harvie256/phasor_fpga/sigrok/README.md

## A bare minimum Sigrok Protocol Decoder

This decoder is for the data stream lines of the AD7779 ADC.  For simplicy of the code, only the first data line is decoded.
Simple to add the others, however it's been kept very simple to allow easy understanding of how a PD can be created.

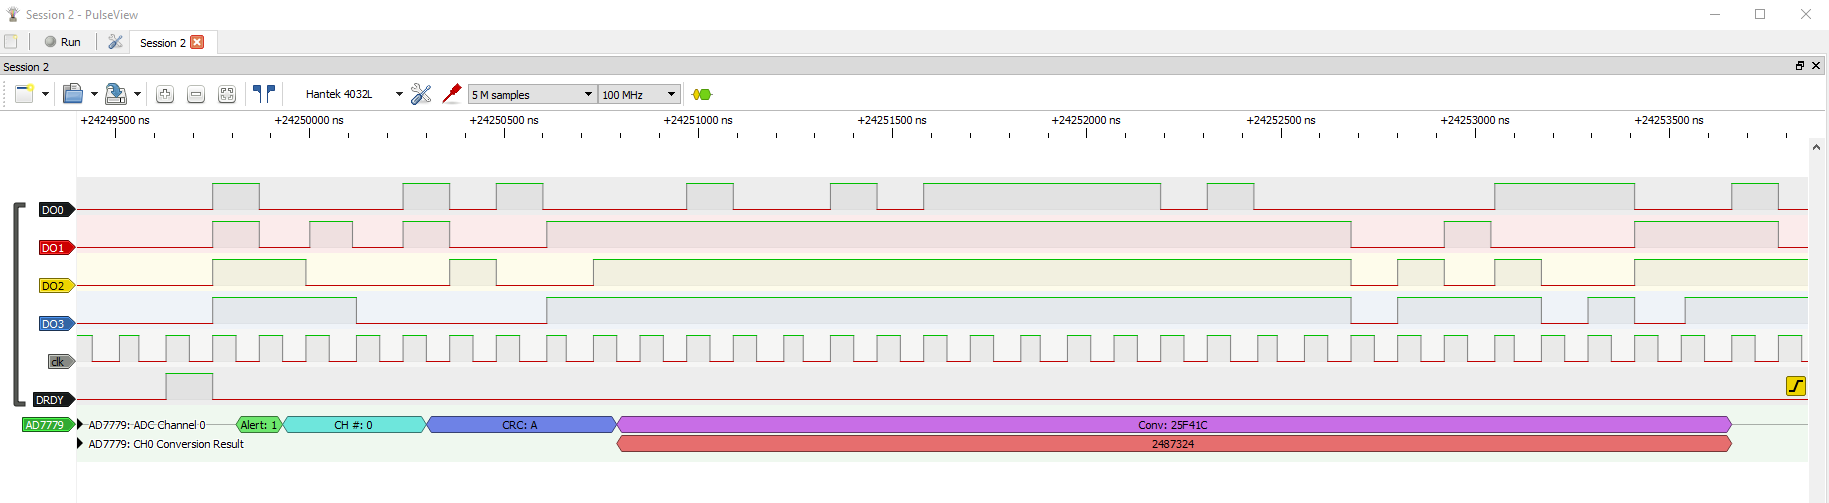
[picture p2: sigrok/Annotation 2020-06-17 120243.png]
Pulseview annotation
