harvie256/phasor_fpga/sigrok/adc_output.png

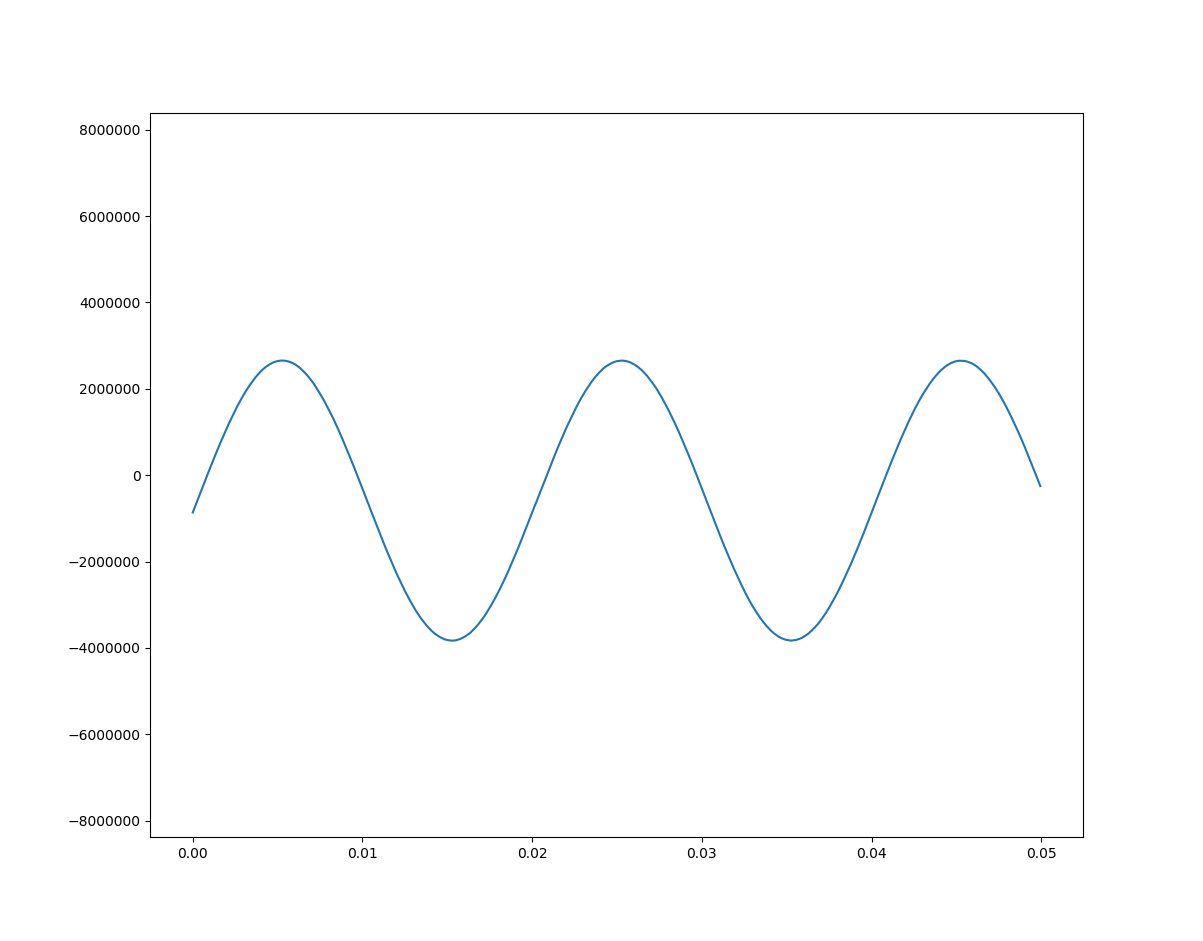
sigrok/adc_output.png
