harvie256/phasor_fpga/FPGA_PMU_PCB/fpga_pmu_pcb_board.pdf

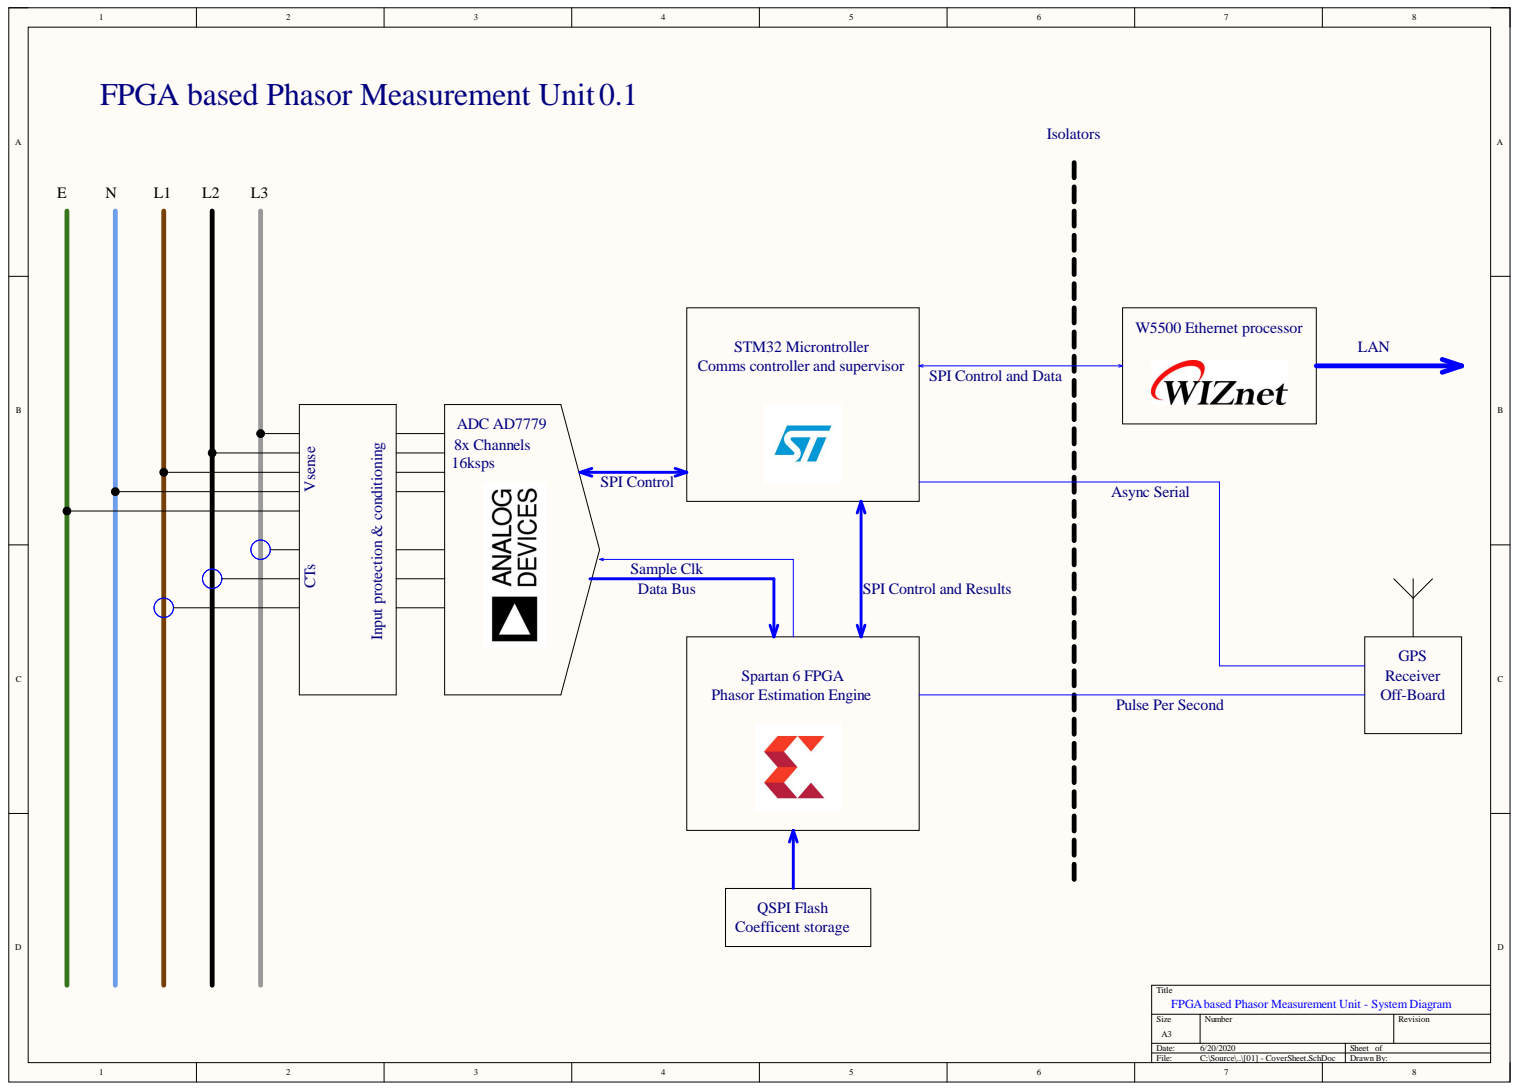
[picture p4: page 1]

FPGA based Phasor Measurement Unit 0.1

STM32 Microntroller
Comms controller and supervisor

SPI Control and Data

SPI Control and Results

Title
FPGA based Phasor Measurement Unit - System Diagram

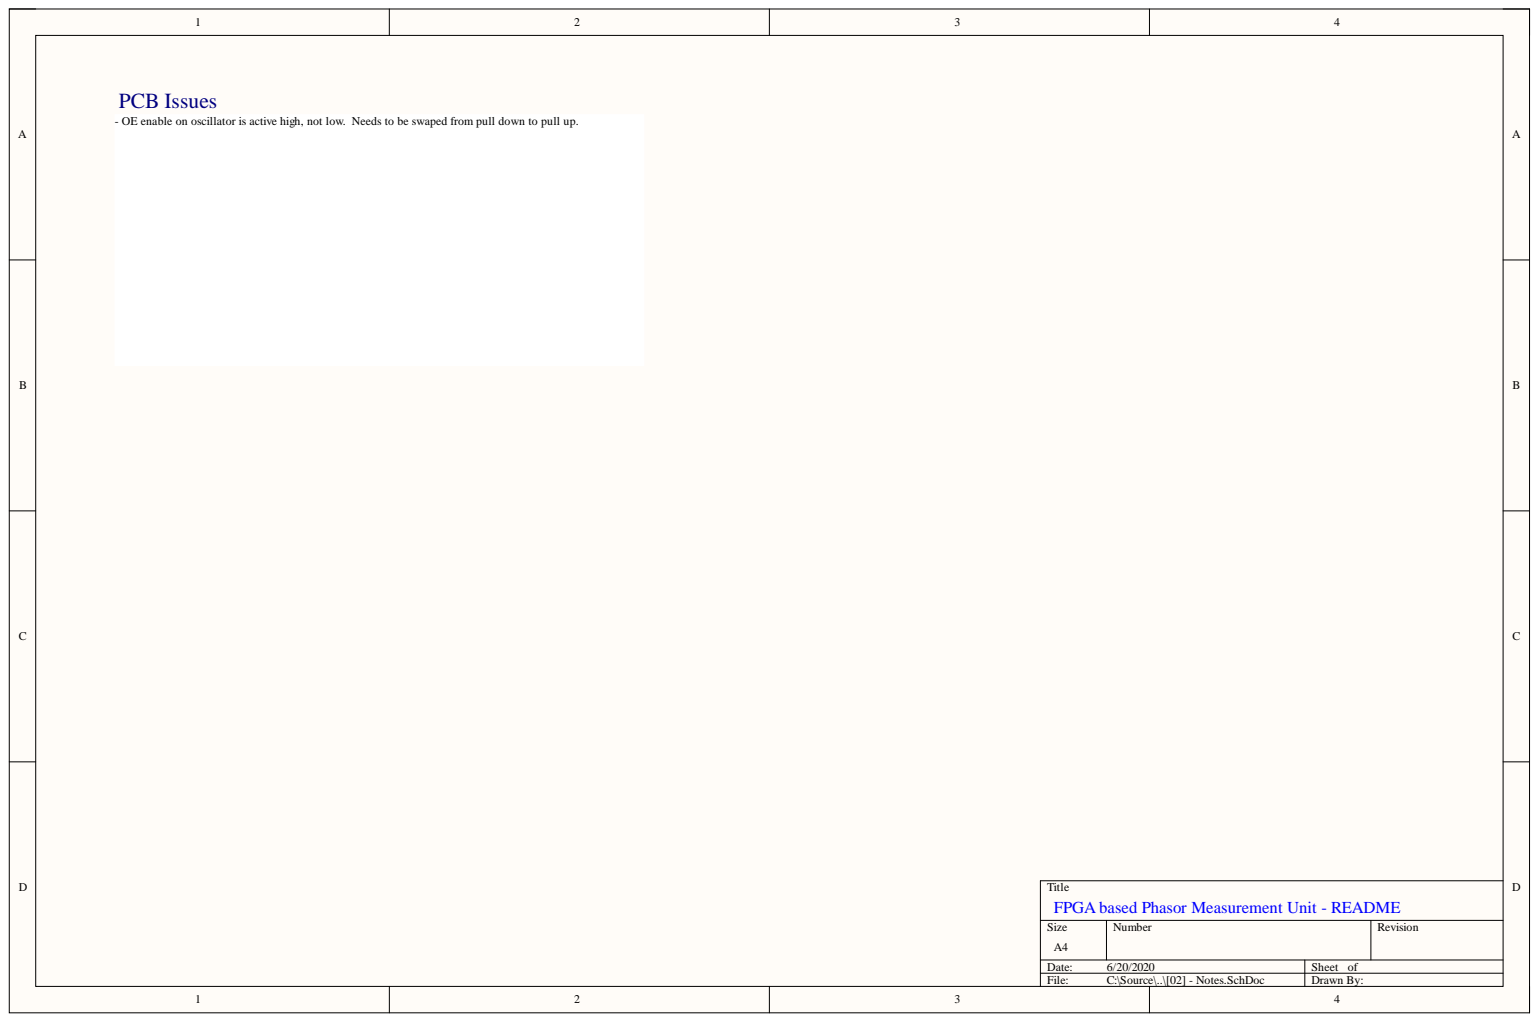
[picture p5: page 2]

- OE enable on oscillator is active high, not low. Needs to be swaped from pull down to pull up.

Title
FPGA based Phasor Measurement Unit - README

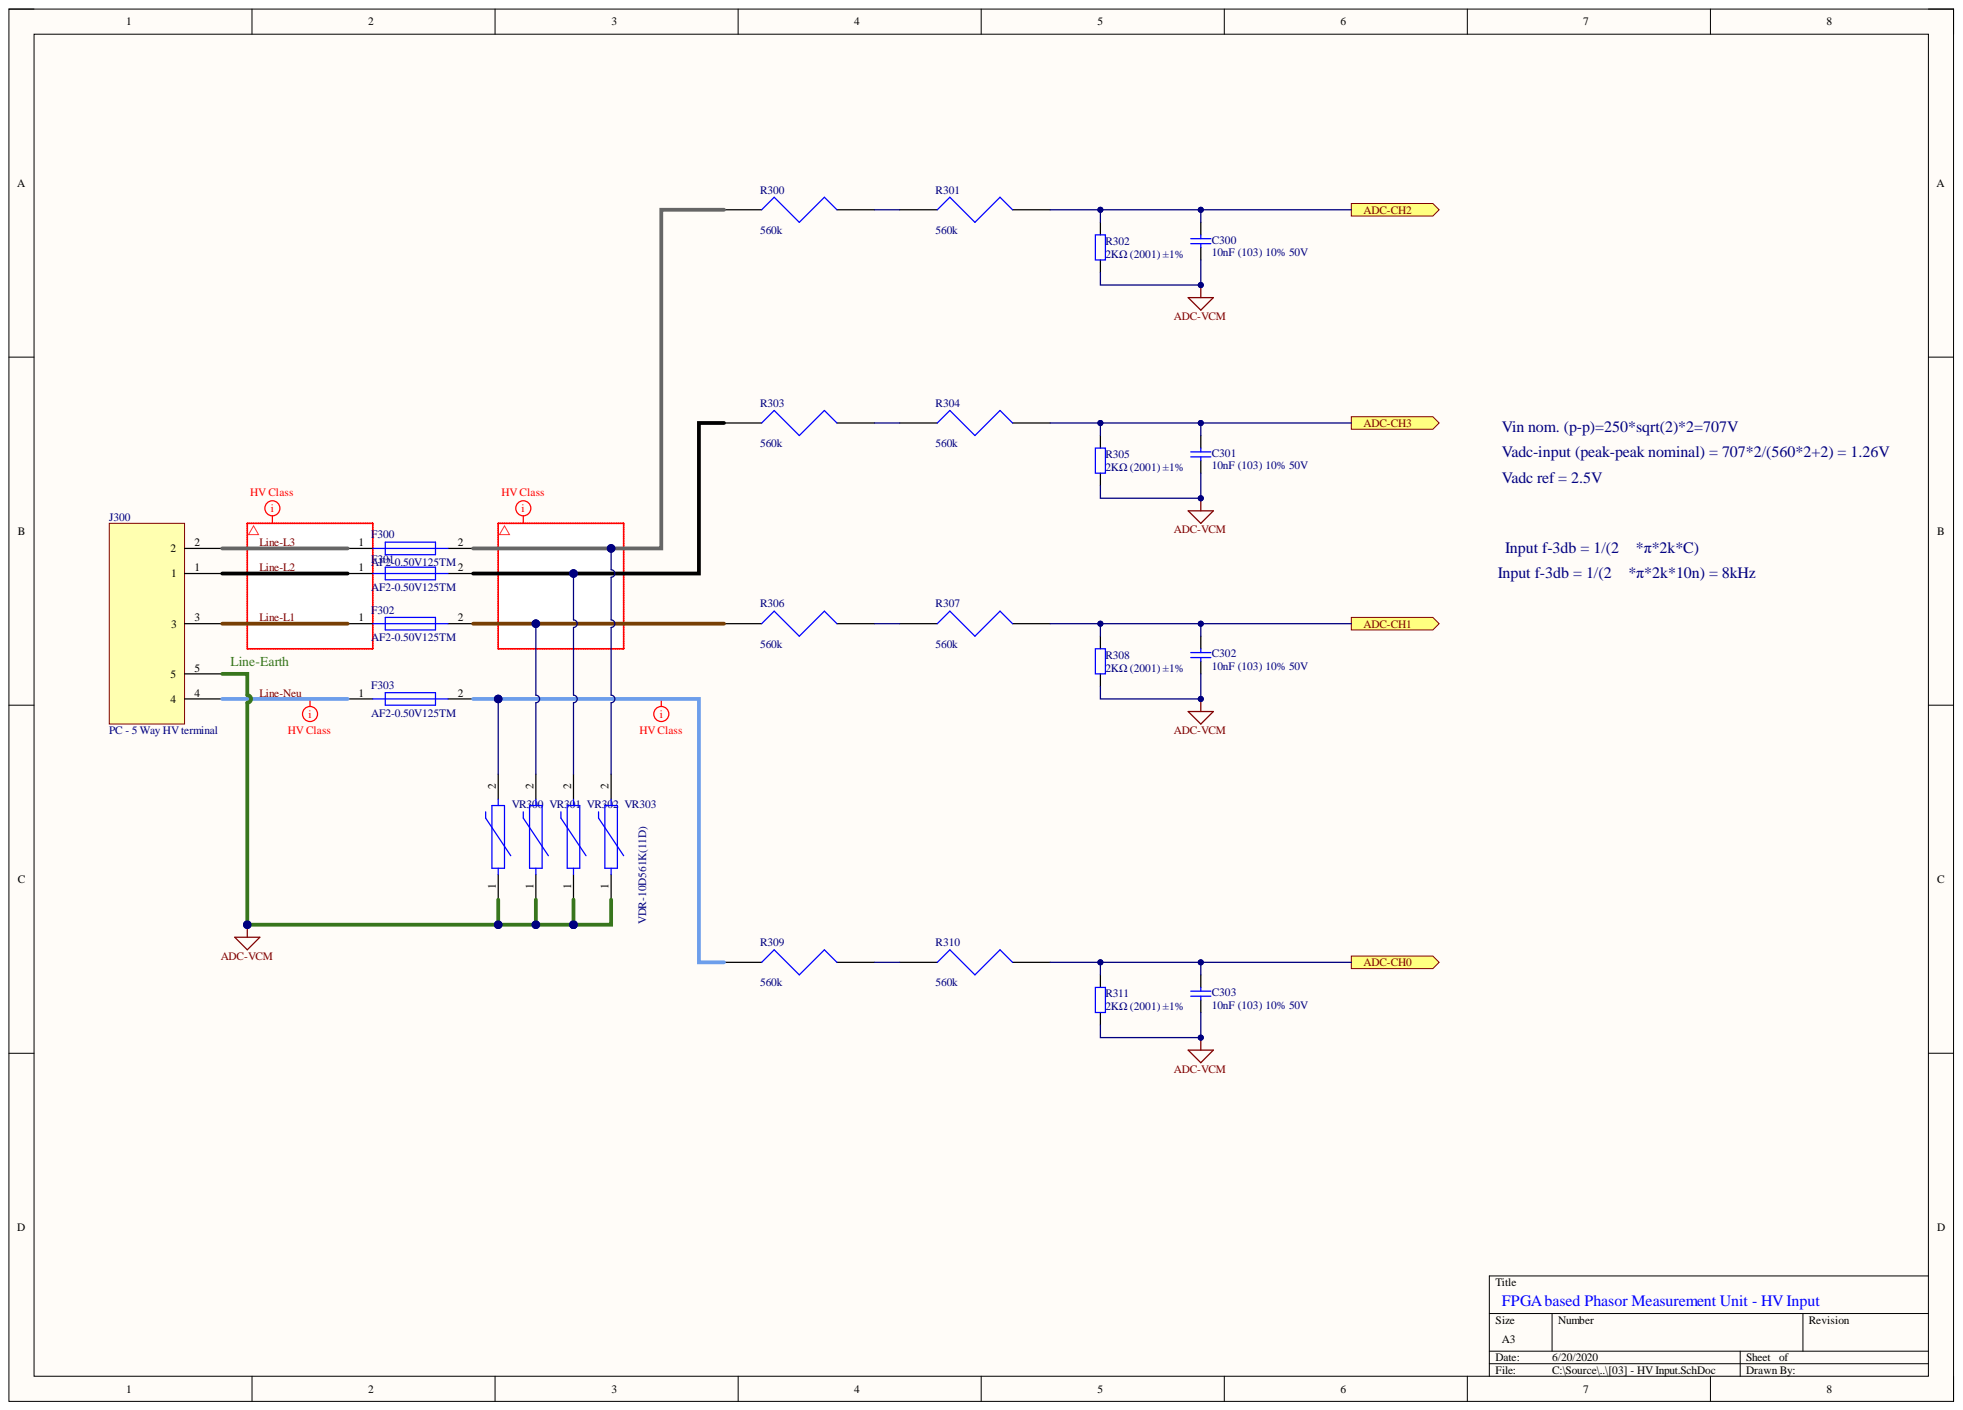
[picture p6: page 3]

Vin nom. (p-p)=250*sqrt(2)*2=707V
Vadc-input (peak-peak nominal) = 707*2/(560*2+2) = 1.26V
Vadc ref = 2.5V

PC - 5 Way HV terminal

Title
FPGA based Phasor Measurement Unit - HV Input

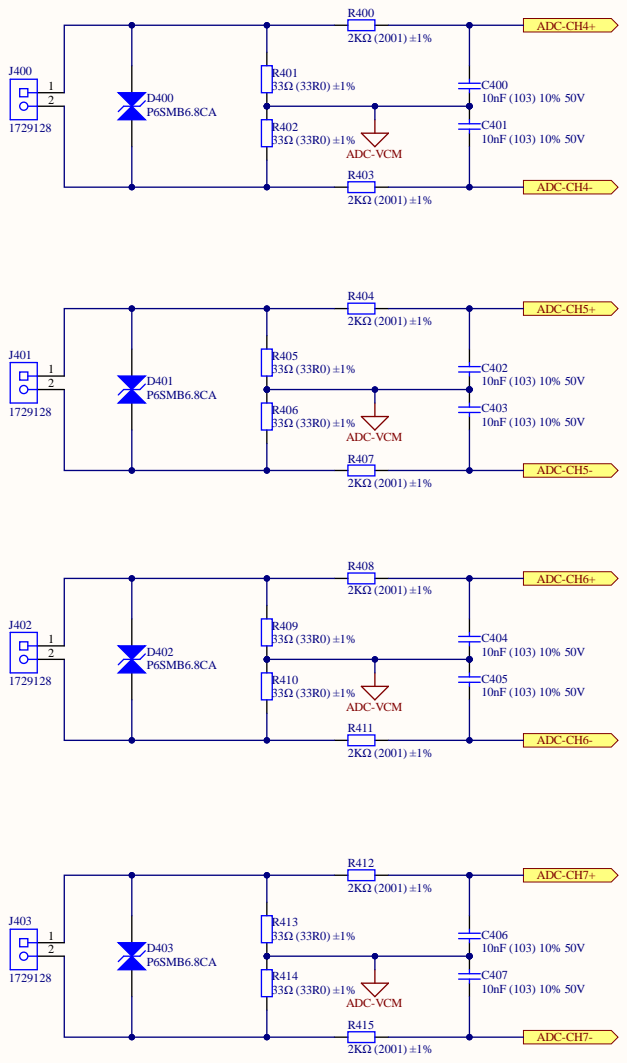
[picture p7: page 4]

Title
FPGA based Phasor Measurement Unit - CT Input

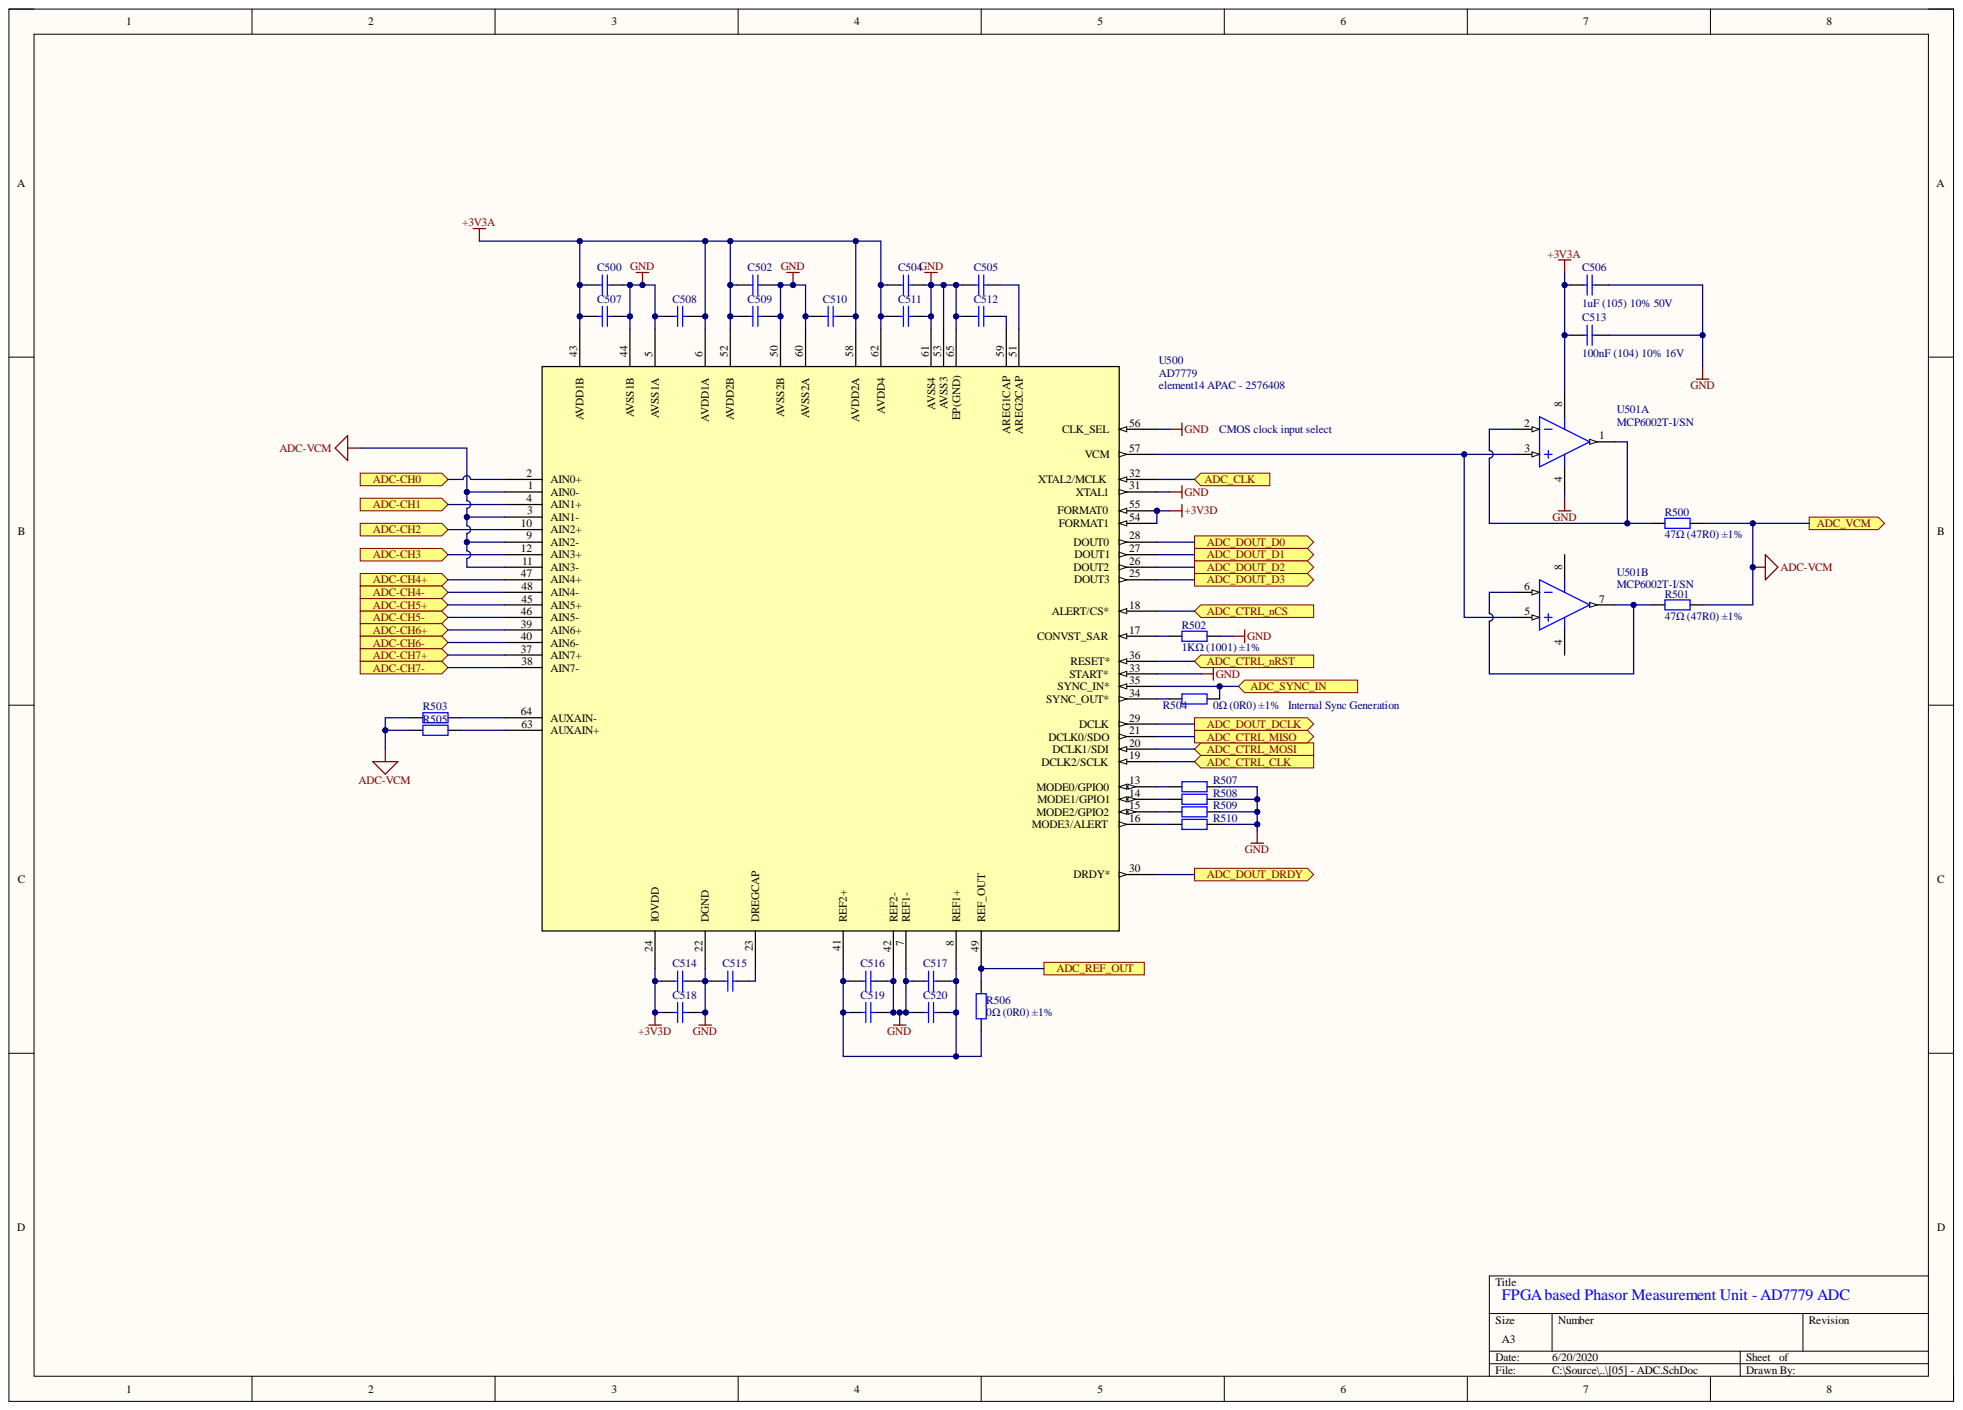
[picture p8: page 5]

GND CMOS clock input select

R505 | AUXAIN+ 63 AUXAIN- 64

R508
R509
R510

Title
FPGA based Phasor Measurement Unit - AD7779 ADC

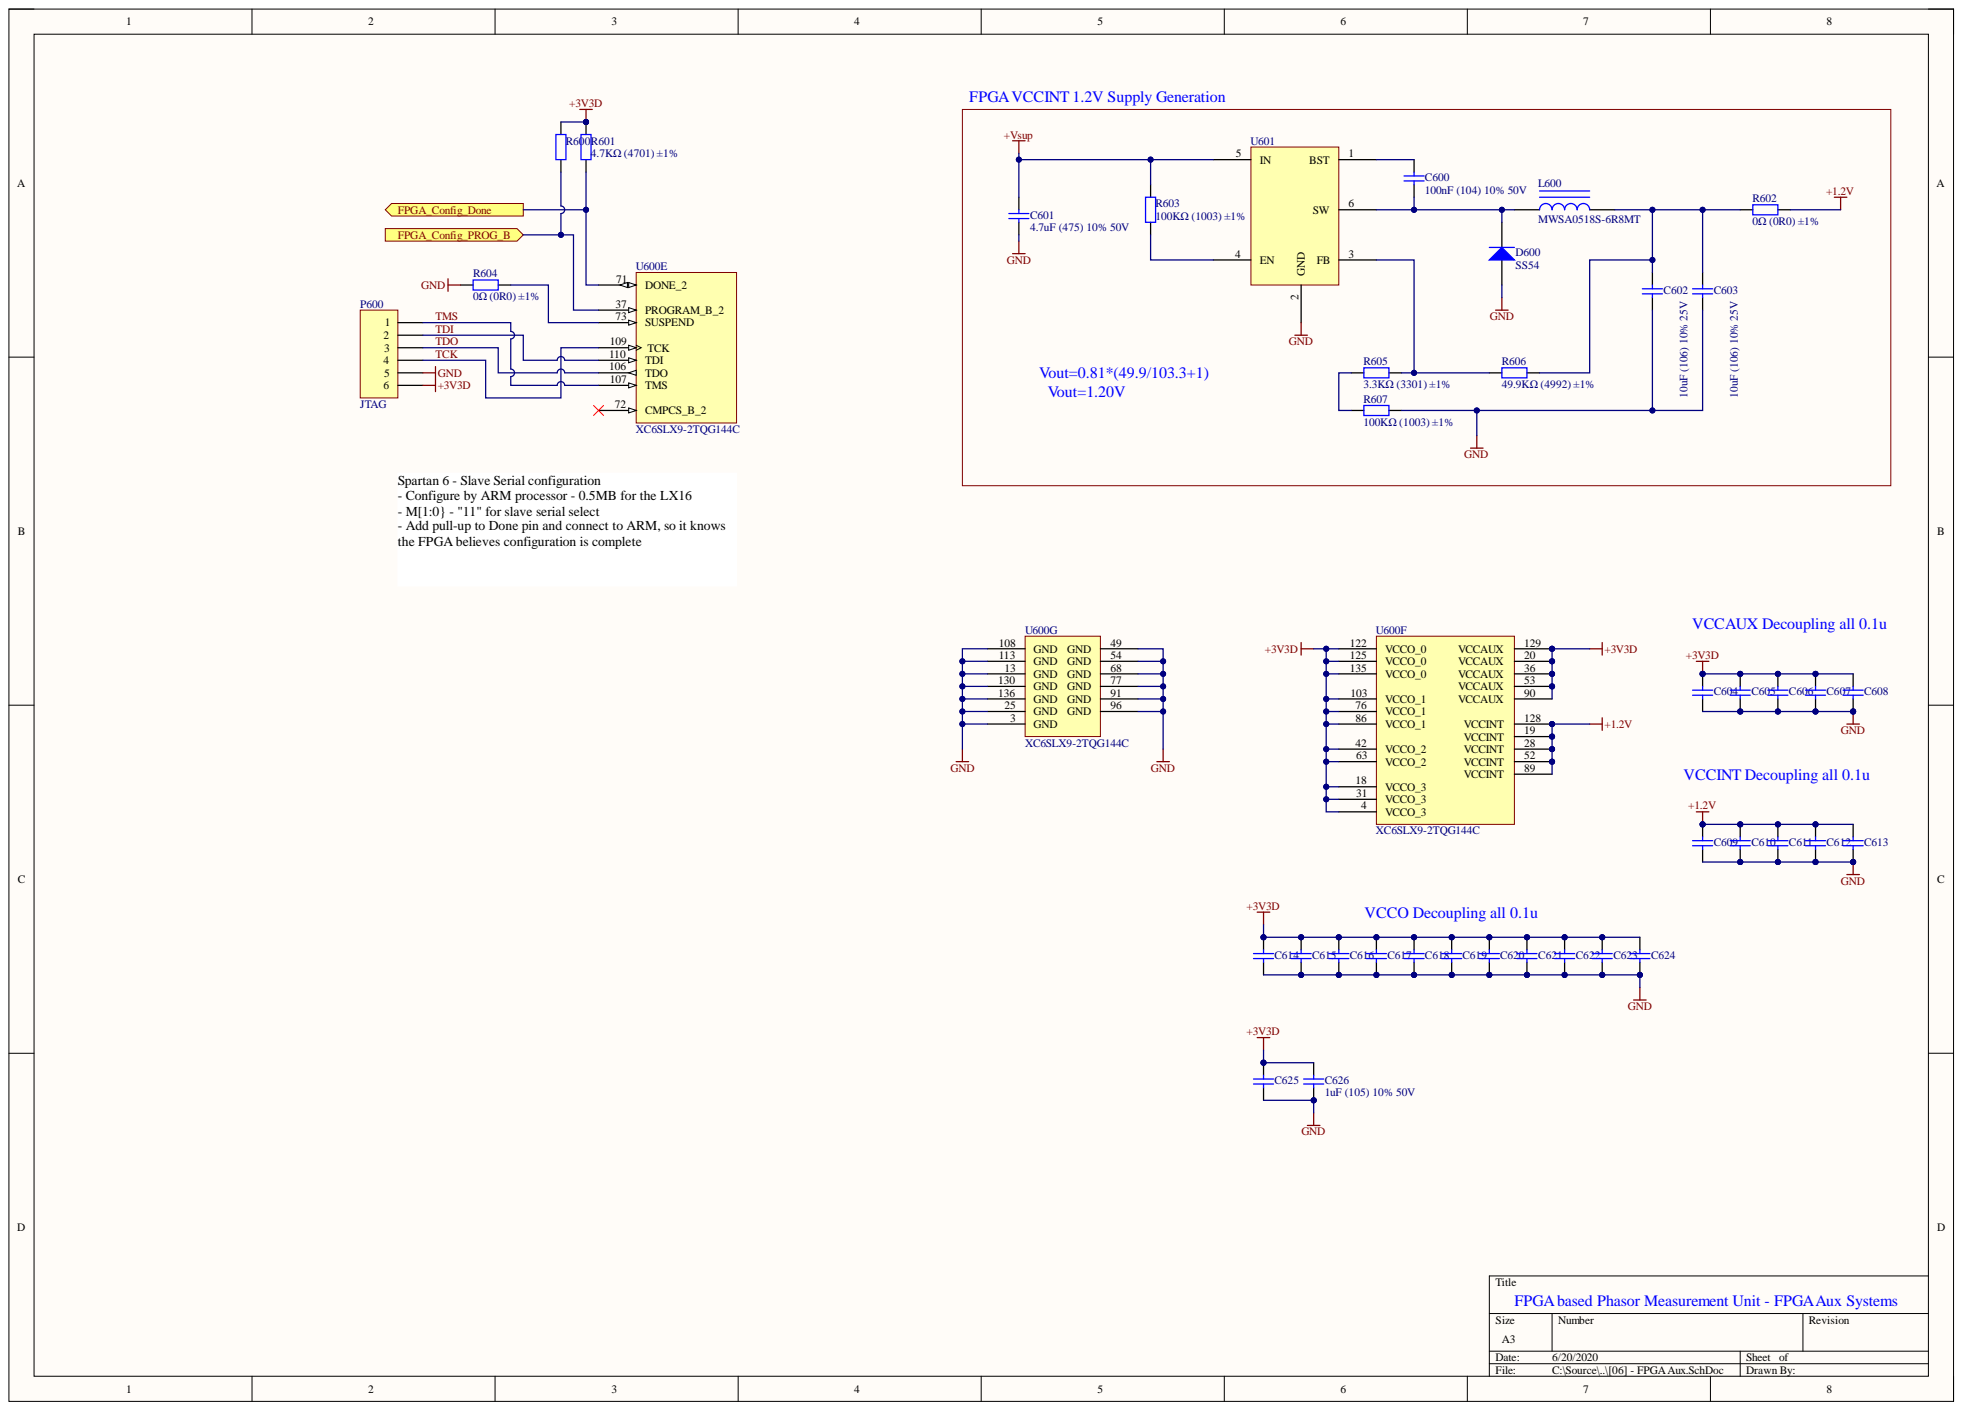
[picture p9: page 6]

TDO
TCK | TDI 110

Spartan 6 - Slave Serial configuration
- Configure by ARM processor - 0.5MB for the LX16
- M[1:0} - "11" for slave serial select
- Add pull-up to Done pin and connect to ARM, so it knows
the FPGA believes configuration is complete

VCCO_3 18

VCCO_3 4

Title
FPGA based Phasor Measurement Unit - FPGAAux Systems

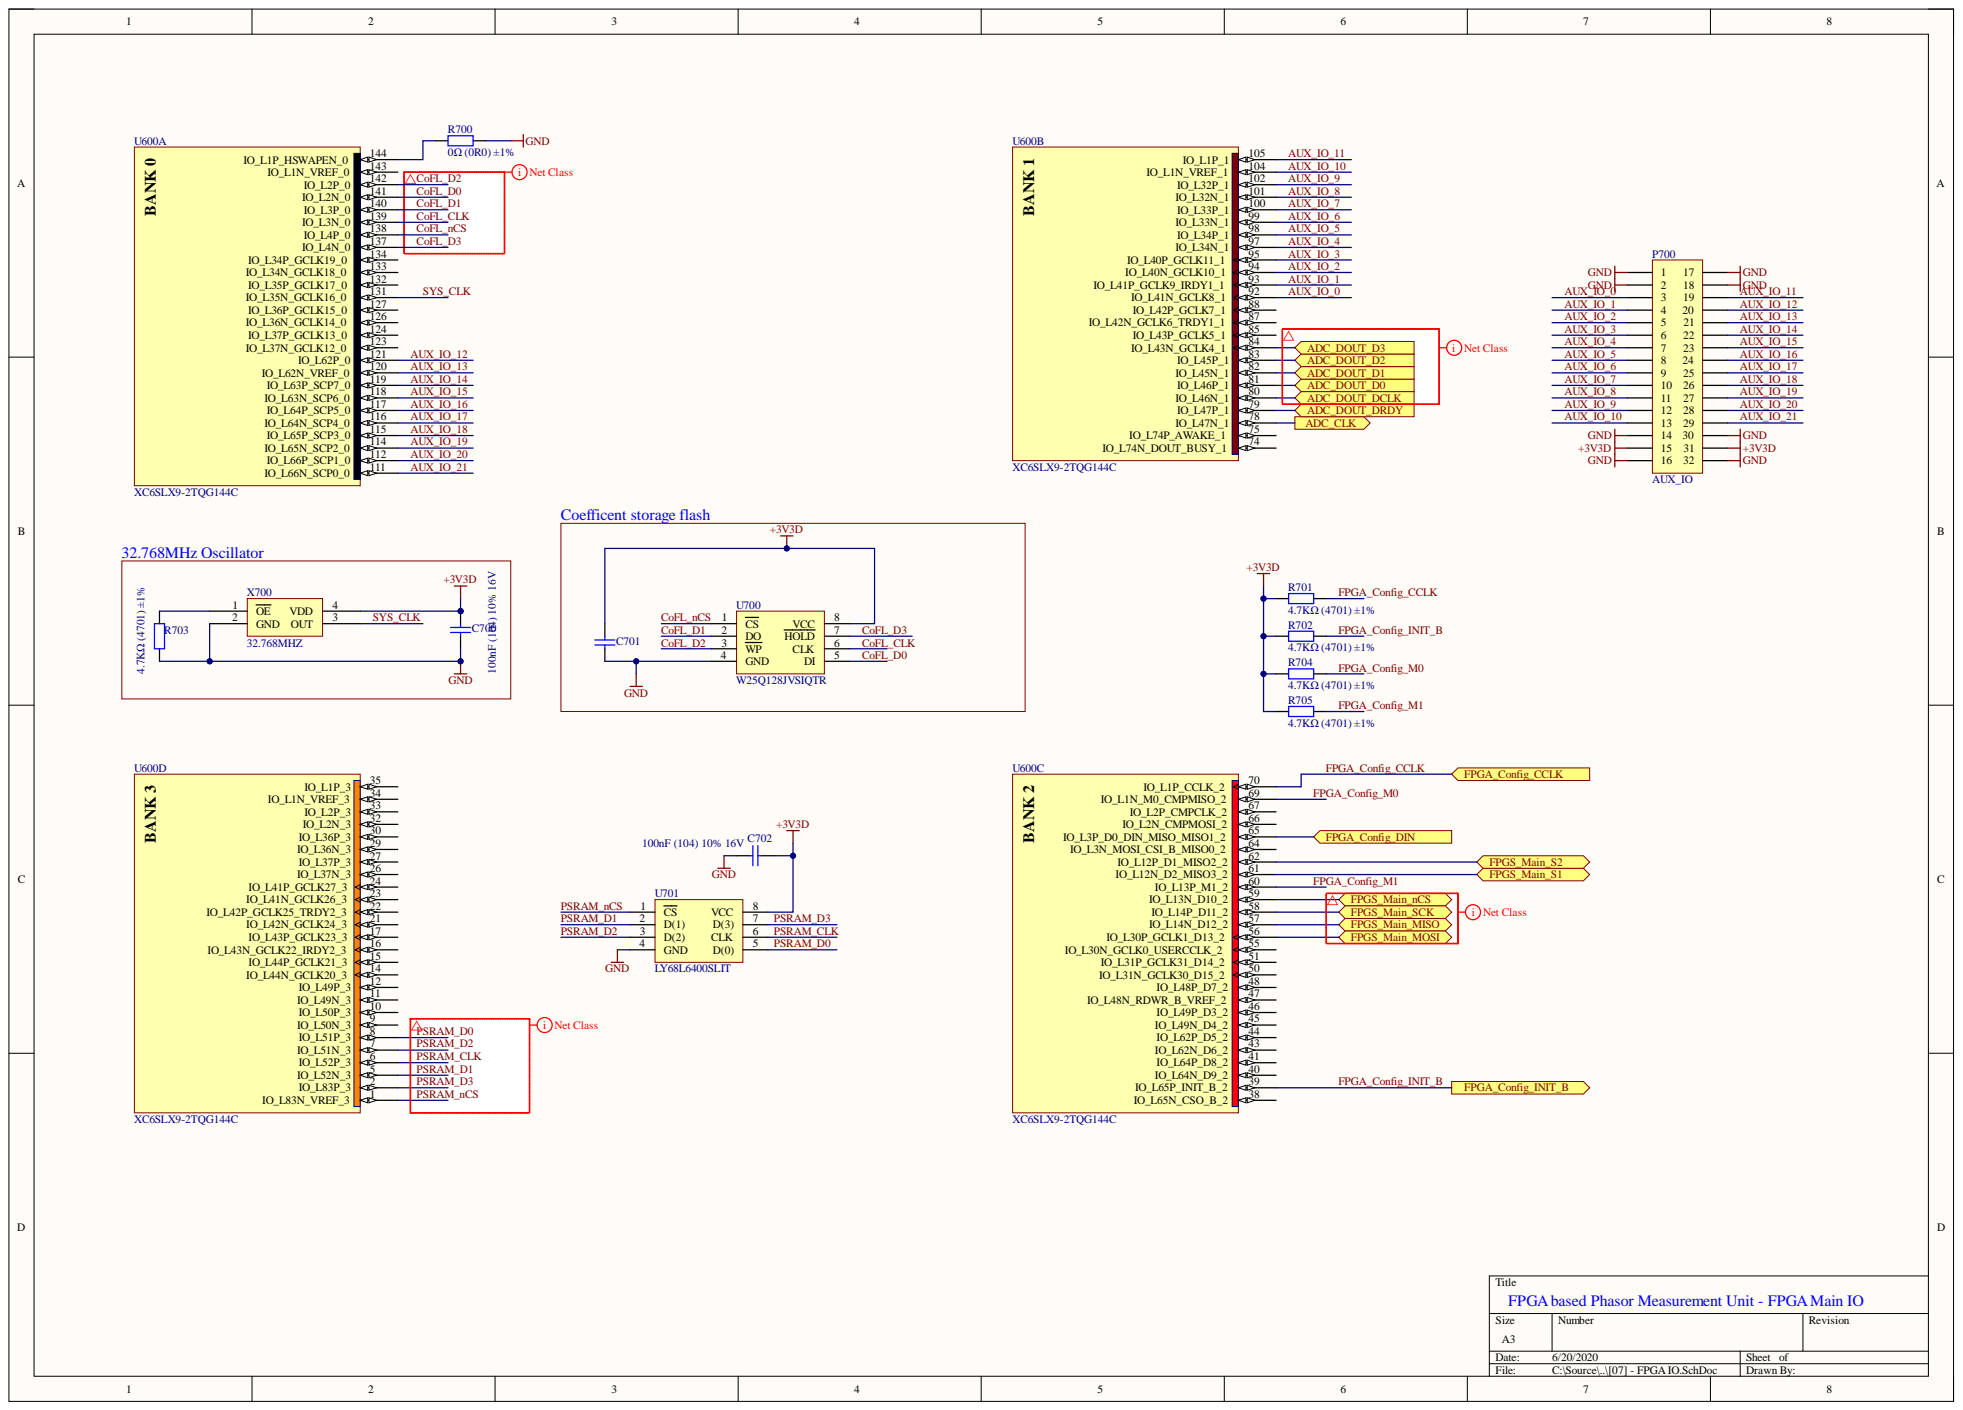
[picture p10: page 7]

Title
FPGA based Phasor Measurement Unit - FPGA Main IO

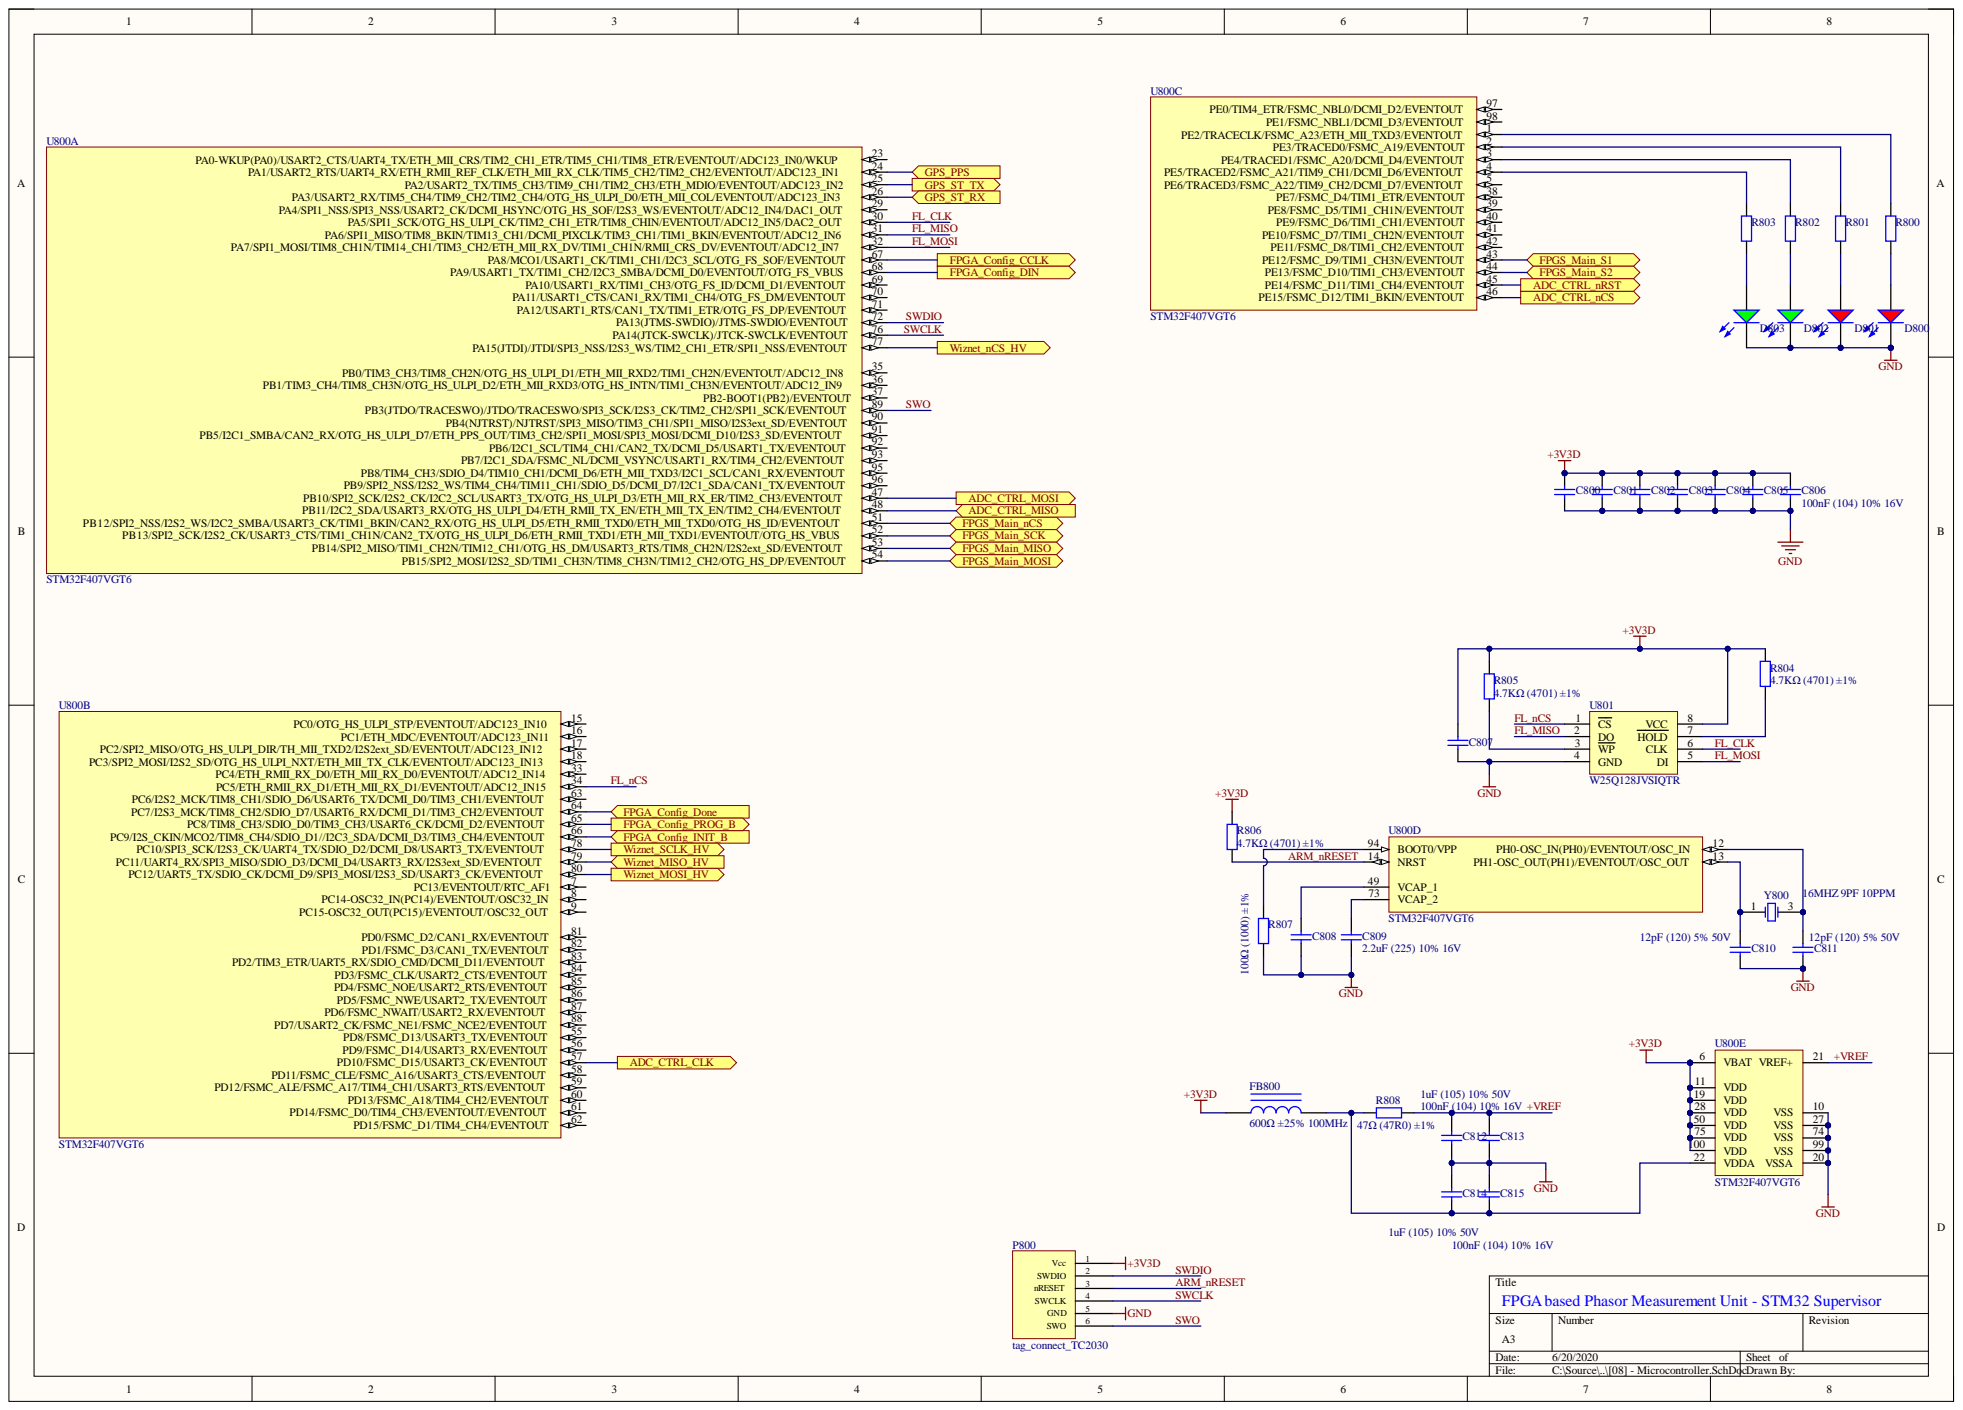
[picture p11: page 8]

Title
FPGA based Phasor Measurement Unit - STM32 Supervisor

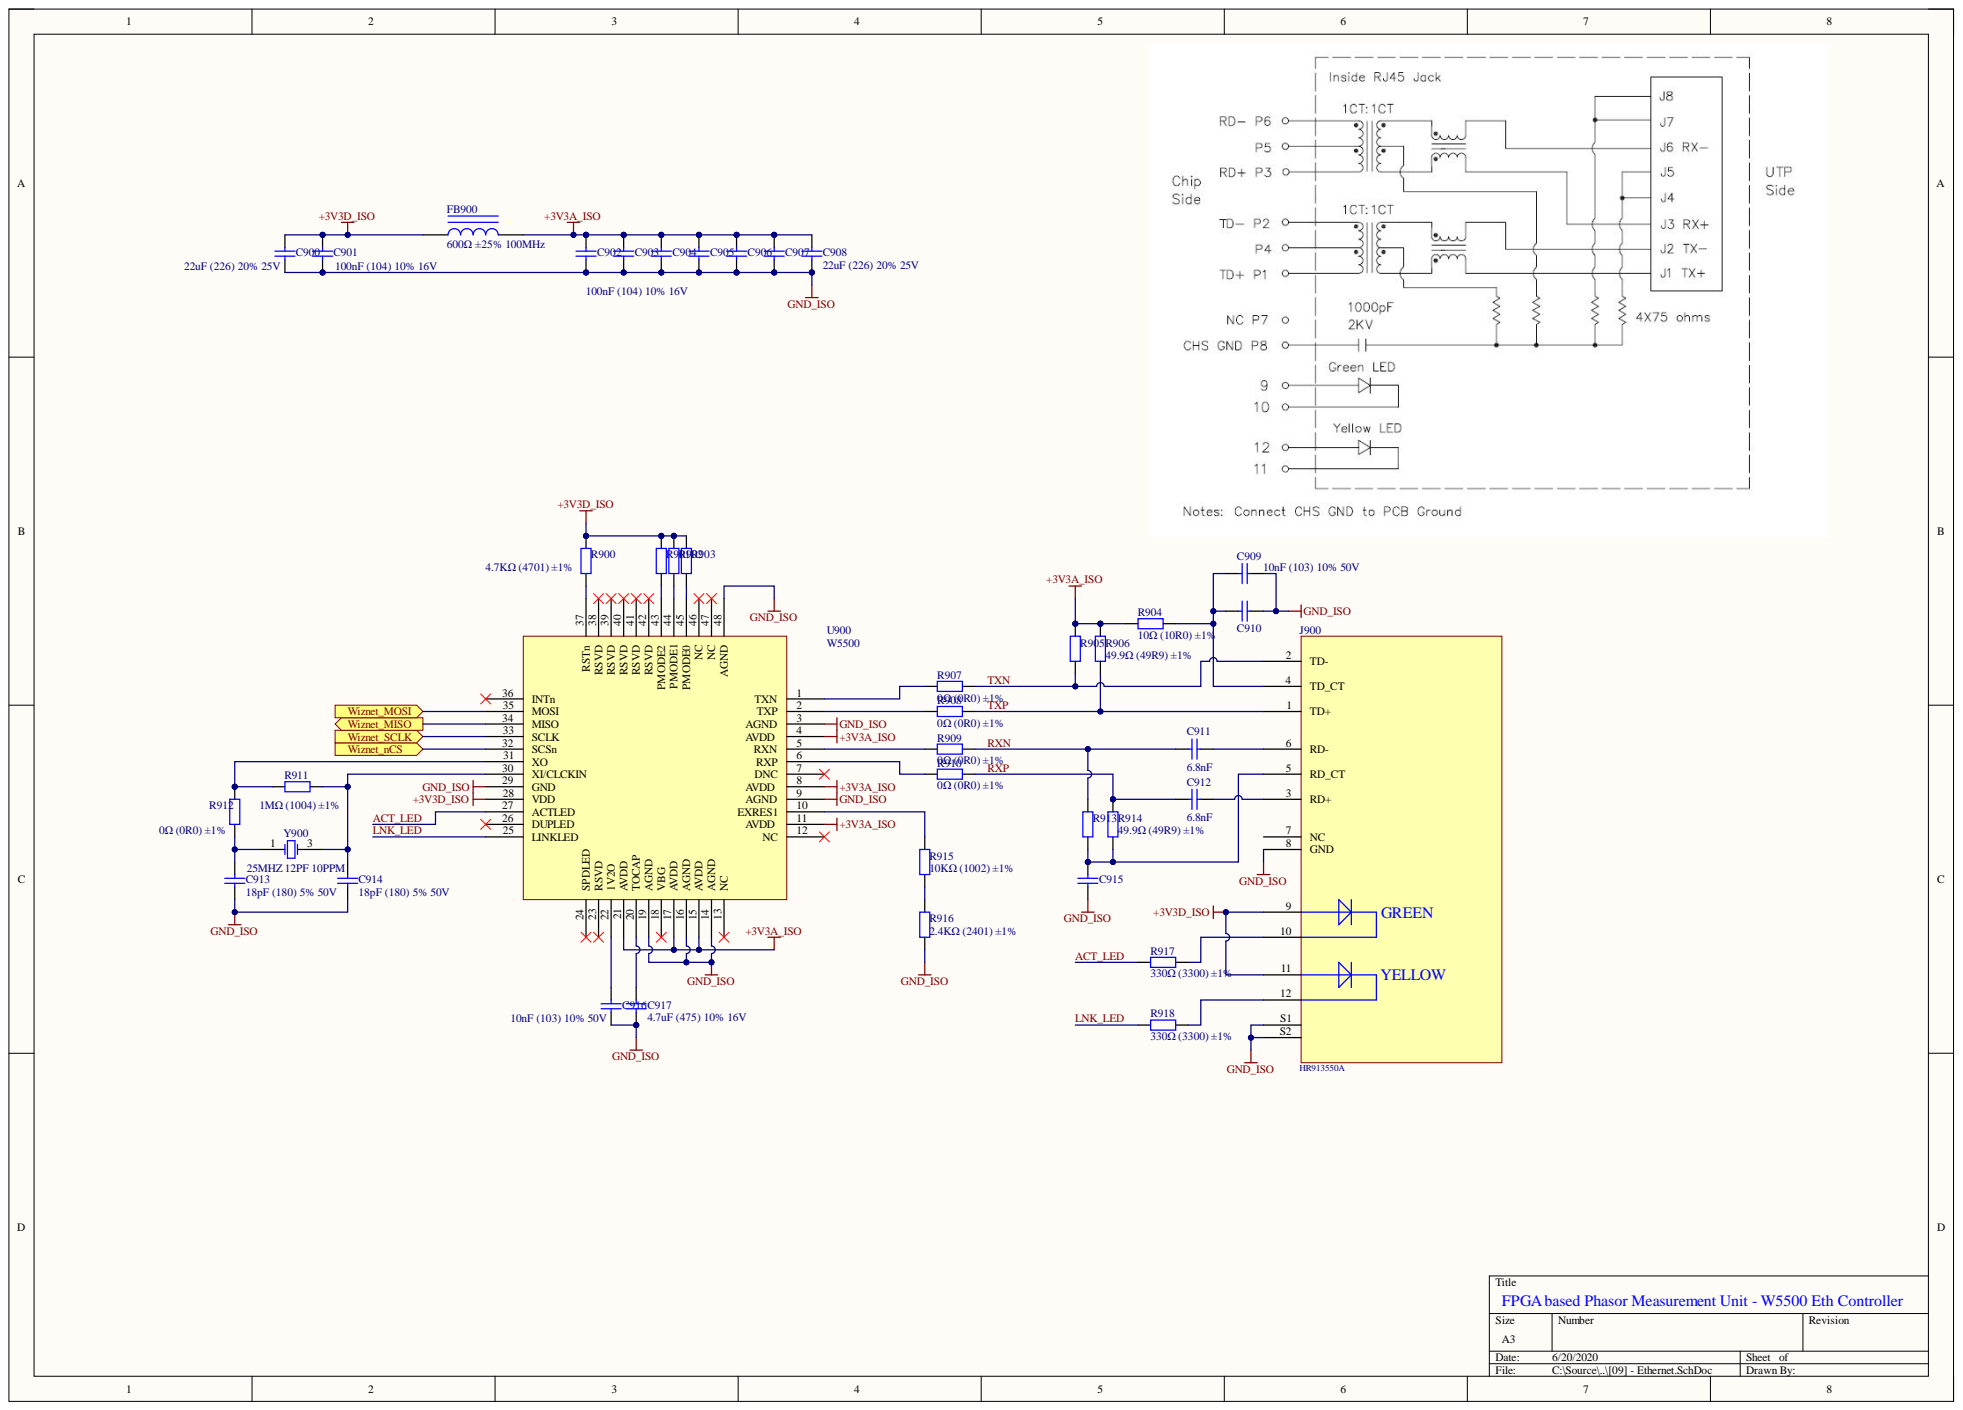
[picture p12: page 9]

TXN

TXP | TD+ 1

NC 13 AGND 14 AVDD 15 AGND 16 AVDD 17 VBG 18 AGND 19 TOCAP 20 AVDD 21 1V2O 22 RSVD 23 SPDLED 24

S1
S2

Title
FPGA based Phasor Measurement Unit - W5500 Eth Controller

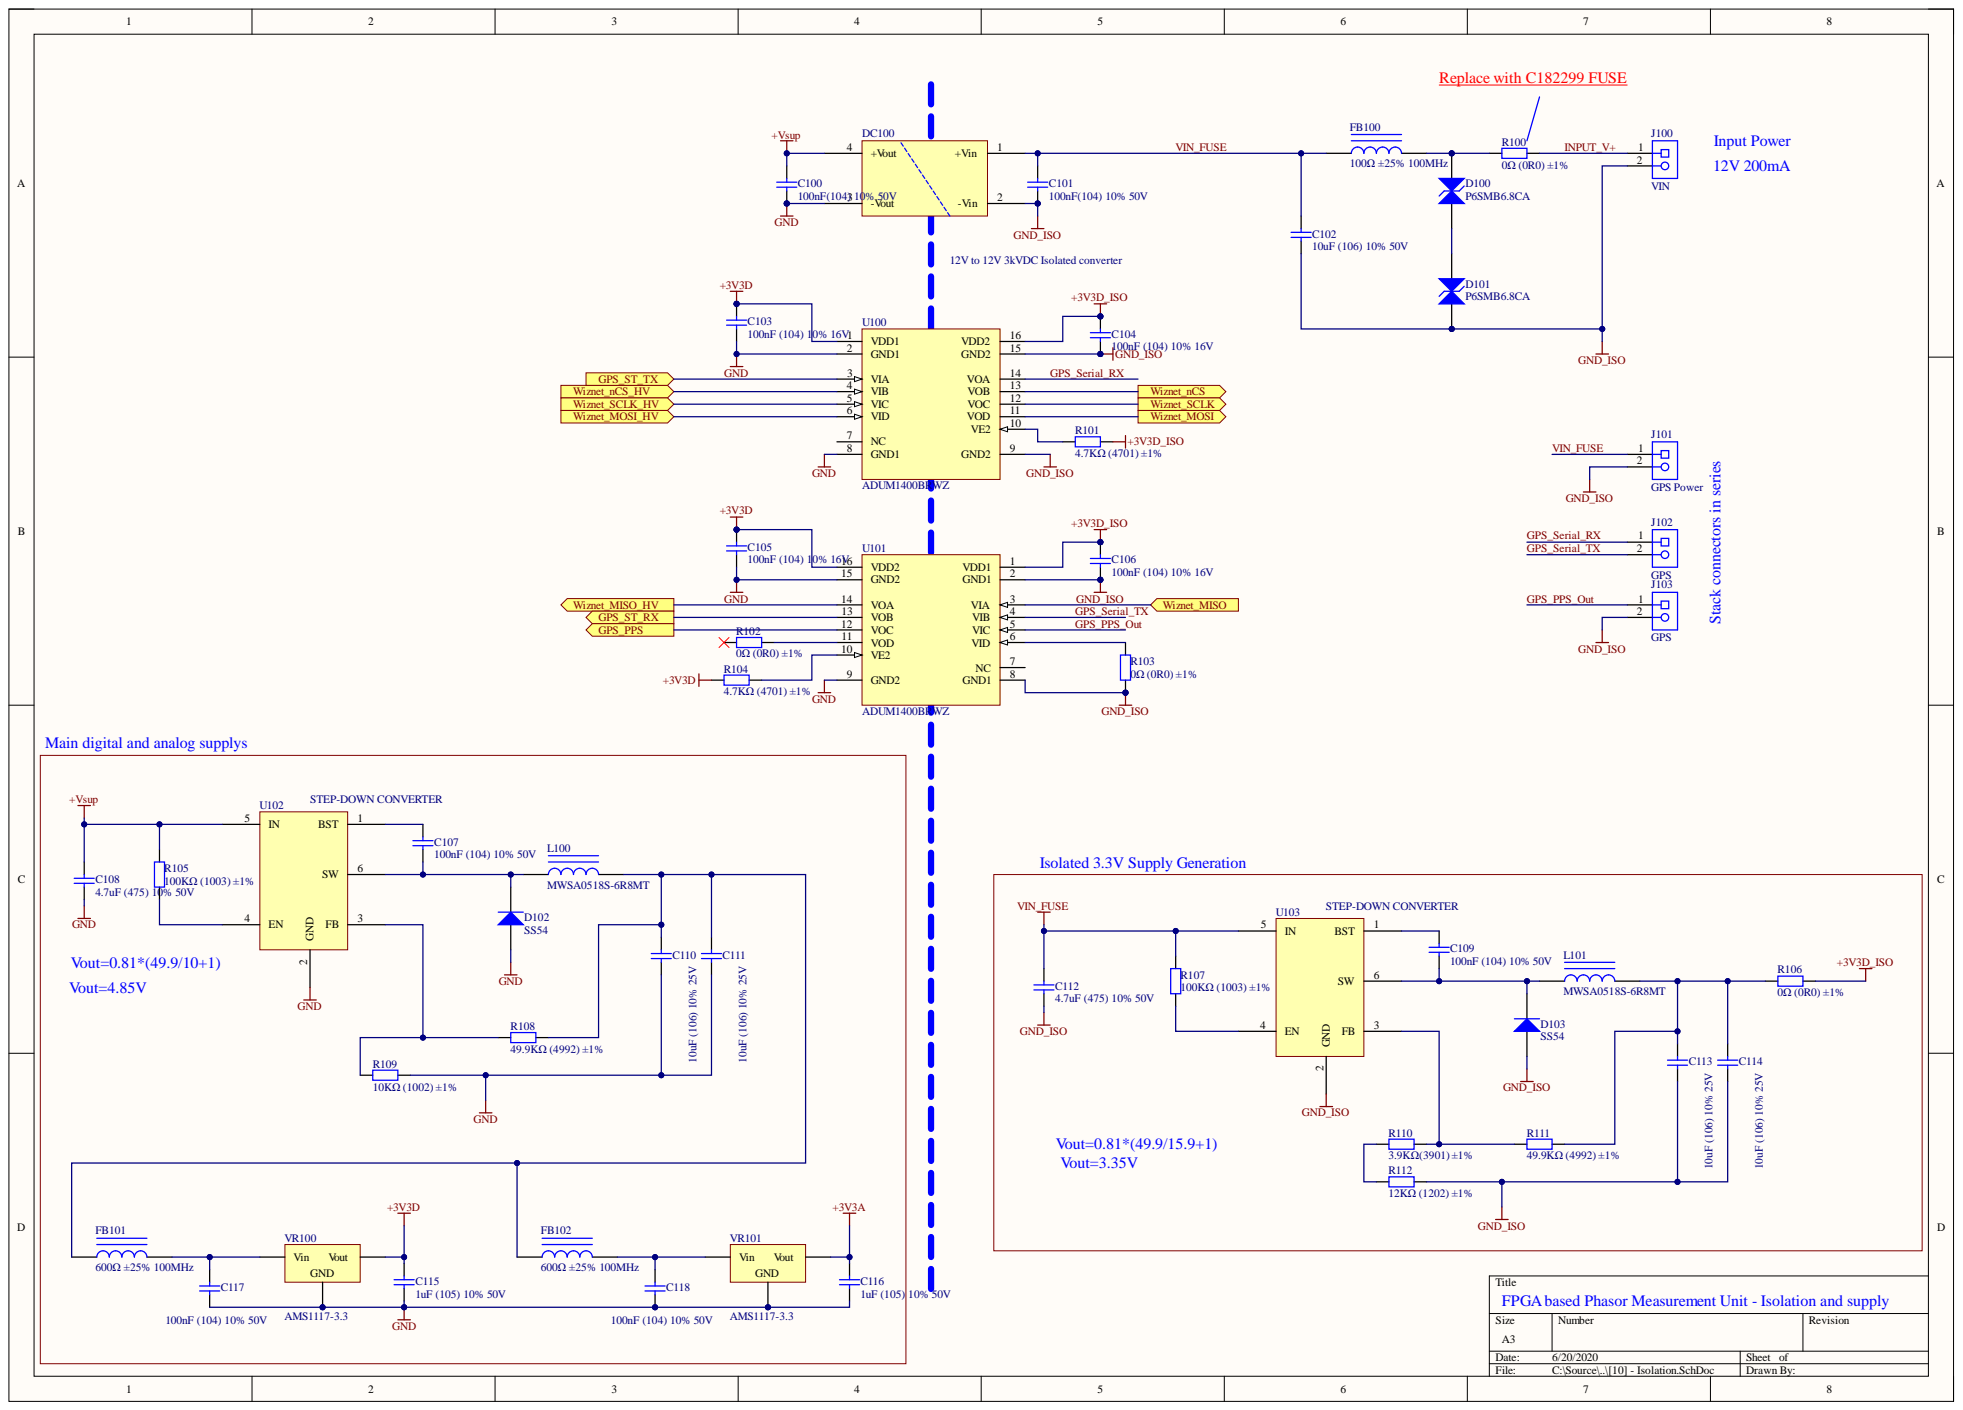
[picture p13: page 10]

Stack connectors in series

Main digital and analog supplys

Title
FPGA based Phasor Measurement Unit - Isolation and supply

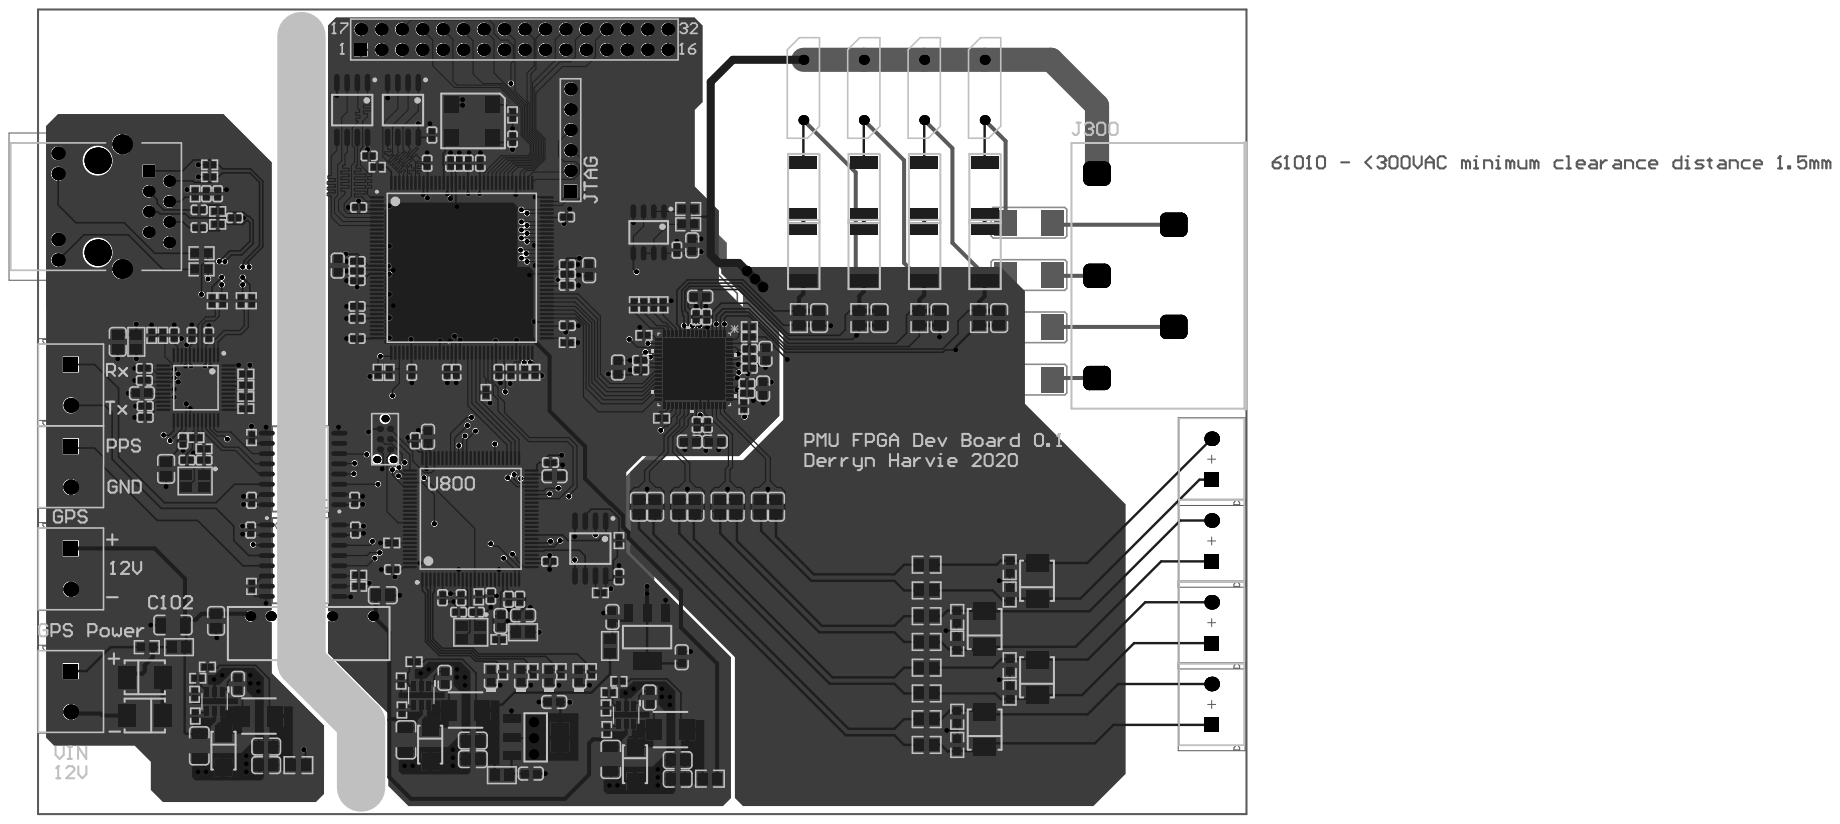
[picture p14: page 11]
