harvie256/phasor_fpga/(list of files, drawings)

Other design files:
FPGA_PMU_PCB/[01] - CoverSheet.SchDoc
FPGA_PMU_PCB/[02] - Notes.SchDoc
FPGA_PMU_PCB/[03] - HV Input.SchDoc
FPGA_PMU_PCB/[04] - Current Transformers.SchDoc
FPGA_PMU_PCB/[05] - ADC.SchDoc
FPGA_PMU_PCB/[06] - FPGA Aux.SchDoc
FPGA_PMU_PCB/[07] - FPGA IO.SchDoc
FPGA_PMU_PCB/[08] - Microcontroller.SchDoc
FPGA_PMU_PCB/[09] - Ethernet.SchDoc
FPGA_PMU_PCB/[10] - Isolation.SchDoc
FPGA_PMU_PCB/fpga_pmu_pcb_board.PrjPcb
FPGA_PMU_PCB/psu_temp.PcbDoc
FPGA_PMU_PCB/psu_temp.SchDoc
