harvie256/phasor_fpga/(commit log)

2020-06-17 Added sigrok/pulseview protocol decoder for ADC data lines
2020-06-20 Added first revision of the PCB
    [[01] - CoverSheet.SchDoc, [02] - Notes.SchDoc, [03] - HV Input.SchDoc, [04] - Current Transformers.SchDoc, [05] - ADC.SchDoc, [06] - FPGA Aux.SchDoc, [07] - FPGA IO.SchDoc, [08] - Microcontroller.SchDoc]
